AirspeedCode/GPS_Logger/README.md

# GPS Logger

An Arduino based GPS data logger using the U-Blox NEO-M8N GPS receiver module.
Saves the data to a micro SD card in a .csv file format which can be opened in Excel, etc. <br>
Convert data to .KMZ format for viewing in Google Earth using GPS Visualiser, here: <br>
https://www.gpsvisualizer.com/map_input?form=googleearth

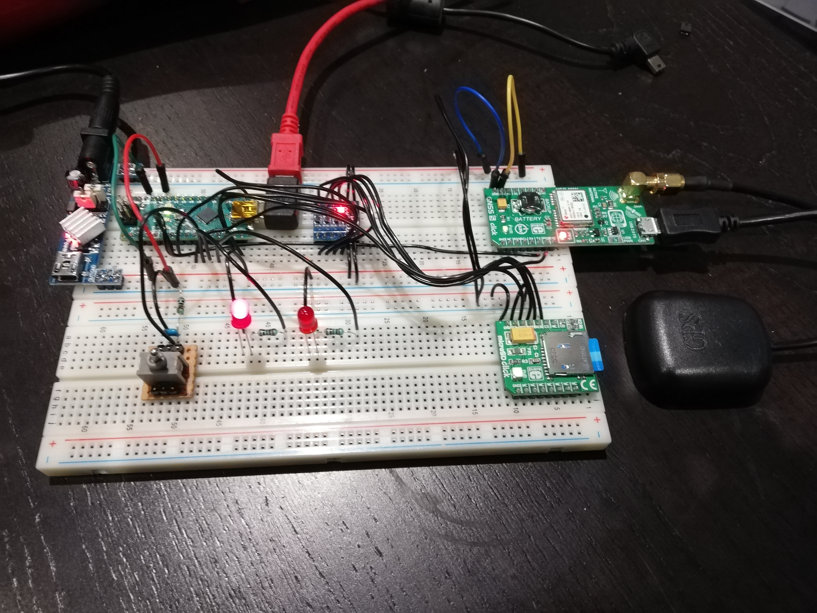
[picture p1: gps_proto.jpg]
Image of GPS Logger prototype


# CSV Data File Format
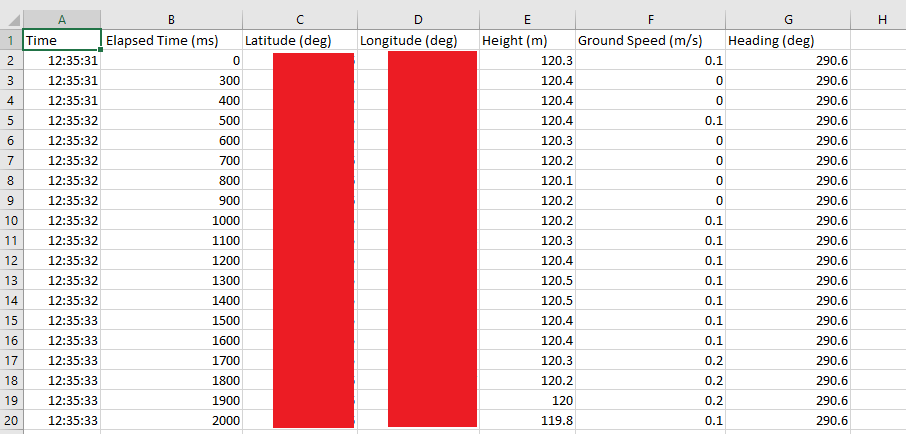
[picture p2: csv_format.PNG]
Image of CSV file format


# Problems
No known problems

# TO DO
1. Put it in a box
2. Add UTC format timestamp to saved data, based on received GPS data
3. Add support for an external XBEE Module, to use UART TX & RX, plus SPI interface
