AirspeedCode/GPS_Logger/GPS Logger Schematic.pdf

## 4 CHANNEL LEVEL

SHIFTER 5V | 3V3

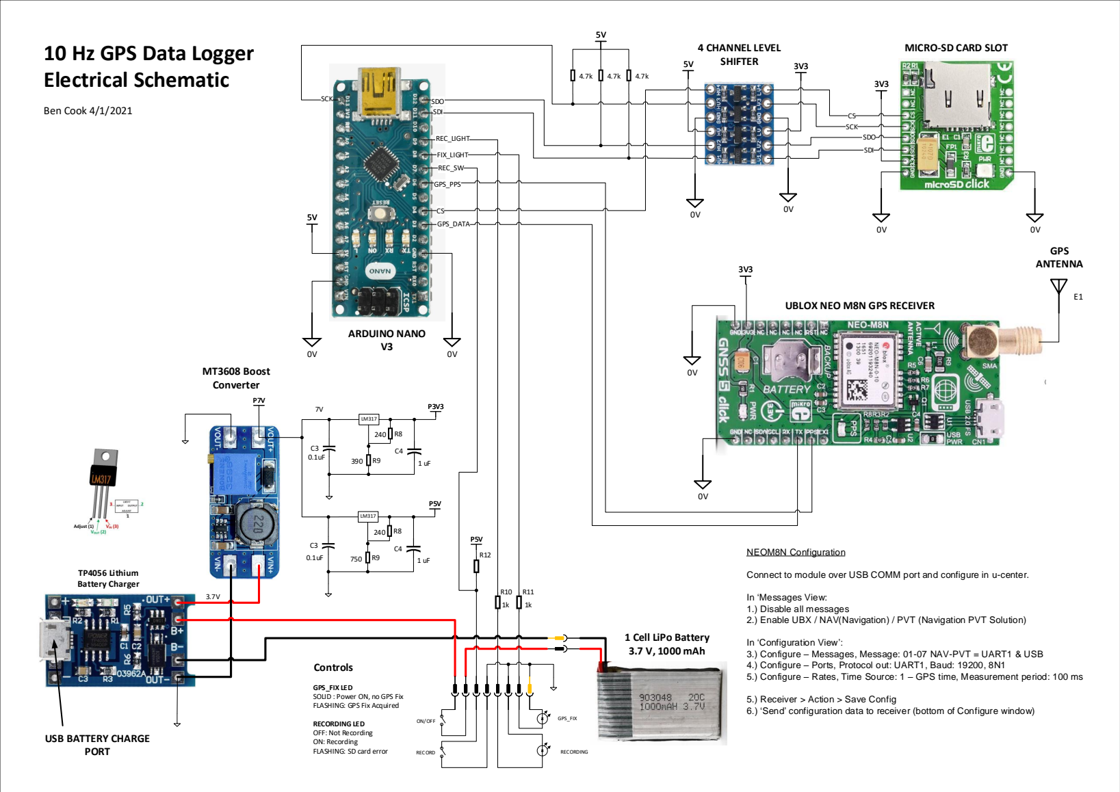
[picture p3: page 1]

10 Hz GPS Data Logger
Electrical Schematic

MICRO-SD CARD SLOT

UBLOX NEO M8N GPS RECEIVER

Connect to module over USB COMM port and configure in u-center.

In ‘Messages View:
1.) Disable all messages
2.) Enable UBX / NAV(Navigation) / PVT (Navigation PVT Solution)

In ‘Configuration View’:
3.) Configure – Messages, Message: 01-07 NAV-PVT = UART1 & USB
4.) Configure – Ports, Protocol out: UART1, Baud: 19200, 8N1
5.) Configure – Rates, Time Source: 1 – GPS time, Measurement period: 100 ms

GPS_FIX LED
SOLID : Power ON, no GPS Fix
FLASHING: GPS Fix Acquired

5.) Receiver > Action > Save Config
6.) ‘Send’ configuration data to receiver (bottom of Configure window)

RECORDING LED
OFF: Not Recording
ON: Recording
FLASHING: SD card error
