AirspeedCode/GPS_Logger/(commit log)

2021-01-04 Added photo of prototype
2021-02-08 Fixed SD card Error in code. Caused by file not closing properly before opening. Schematics updated also to add pullup resistors on SPI bus to SD card.
    [GPS_LOGGER.ino]
